eugmes/ais-recv/out/ais-recv-render.jpg

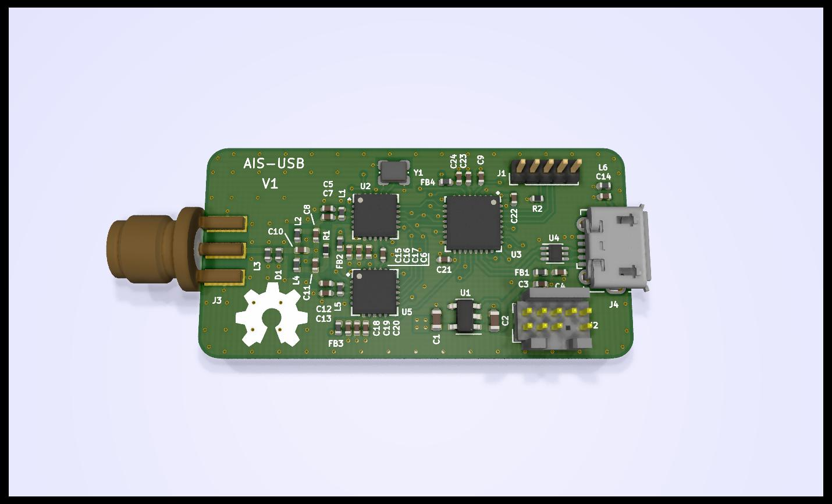
out/ais-recv-render.jpg
