eugmes/ais-recv/out/ais-recv.pdf

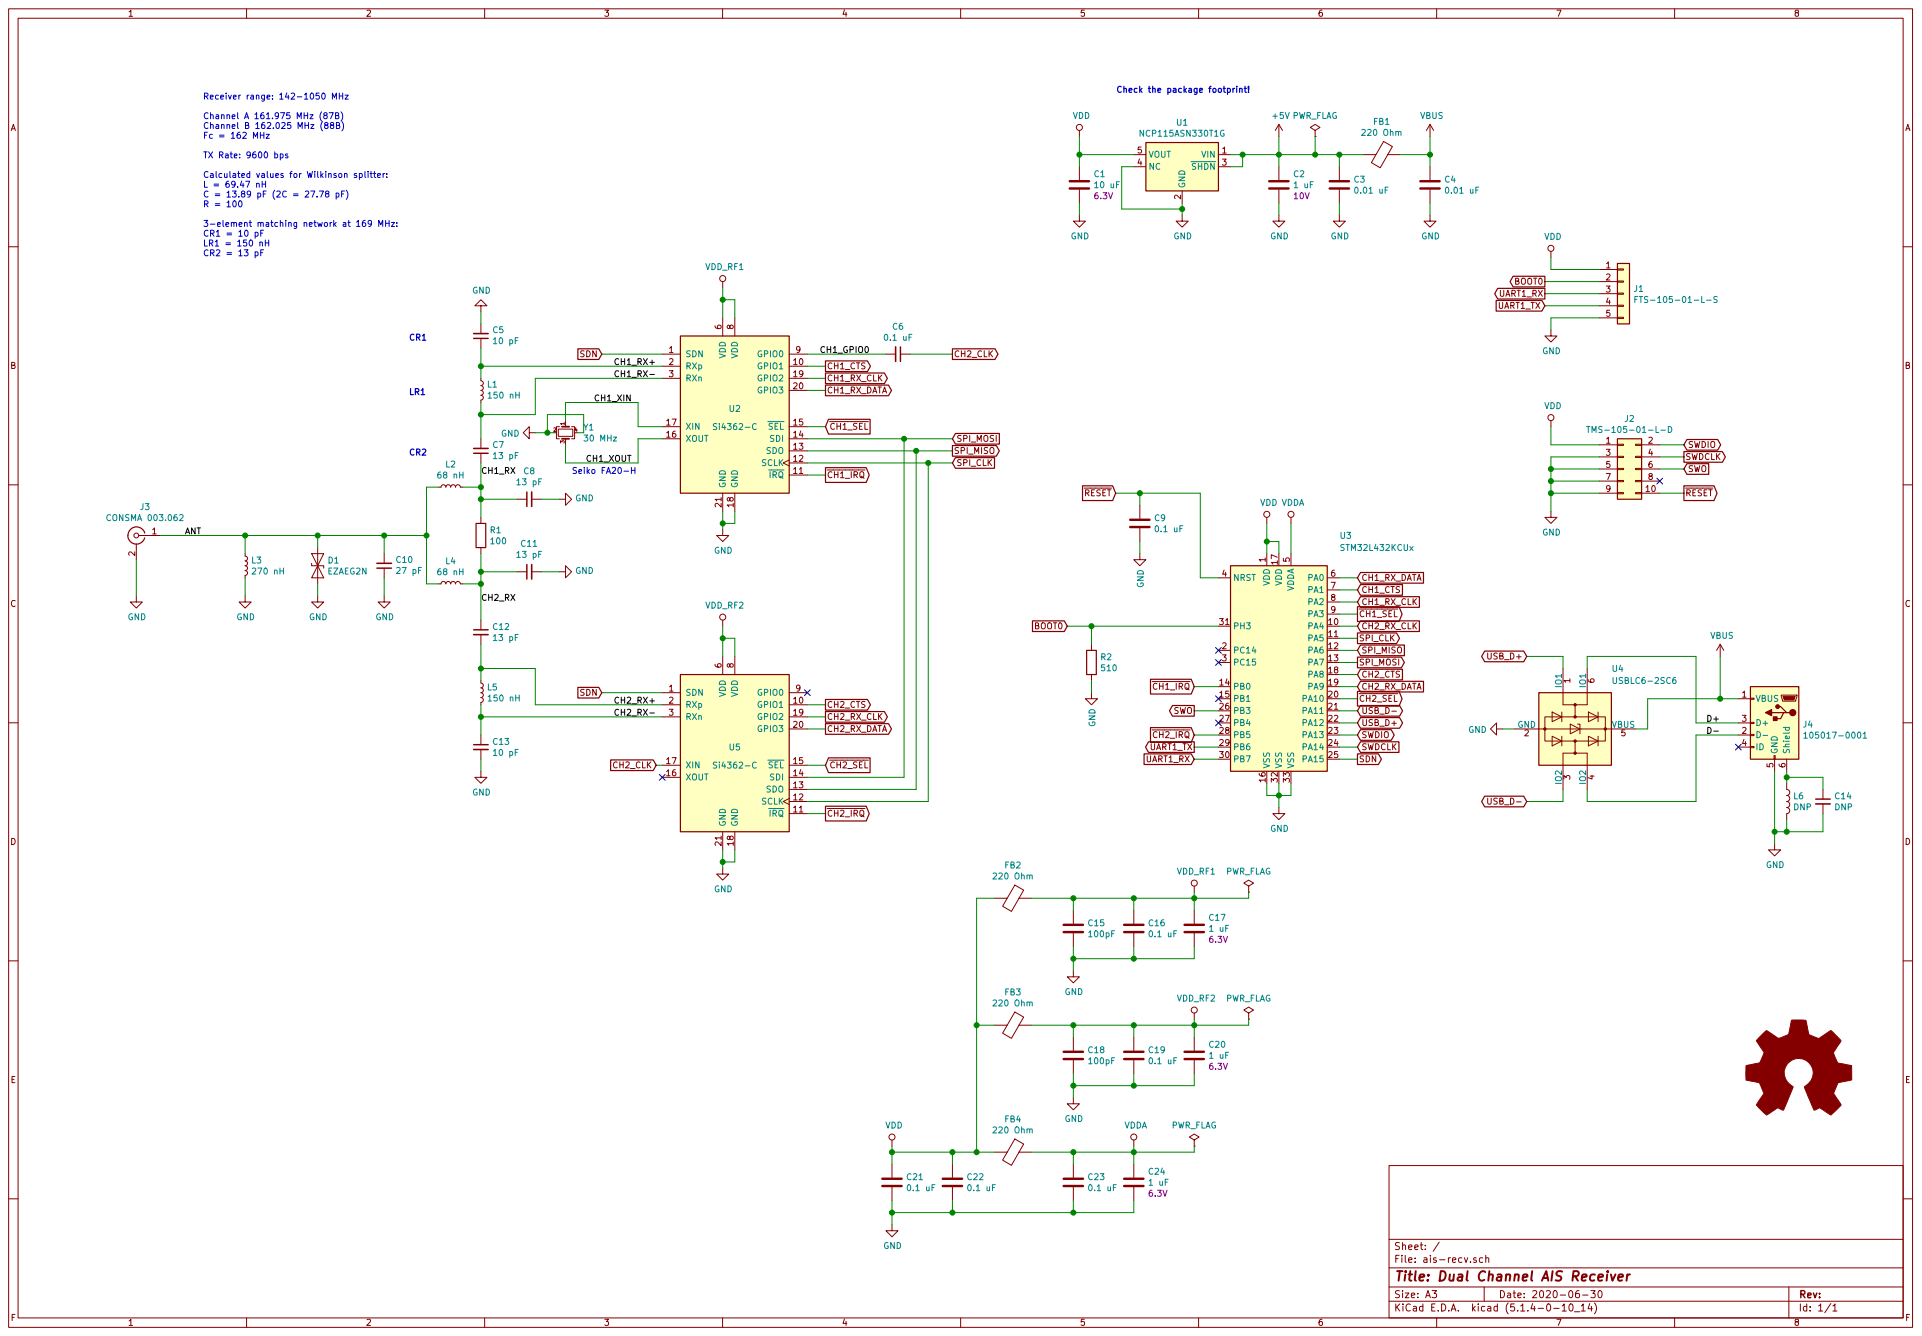
[picture p2: page 1]

Check the package footprint! CR1 Receiver range: 142-1050 MHz

Channel A 161.975 MHz (87B)
Channel B 162.025 MHz (88B) Fc = 162 MHz TX Rate: 9600 bps
10 pF GND

Calculated values for Wilkinson splitter: L = 69.47 nH

3-element matching network at 169 MHz:

Id: 1/1 Title: Dual Channel AIS Receiver File: ais-recv.sch Sheet: /
