eugmes/ais-recv/ais-recv.kicad_pcb

## KiCad design ais-recv.kicad_pcb (2020-08-30)

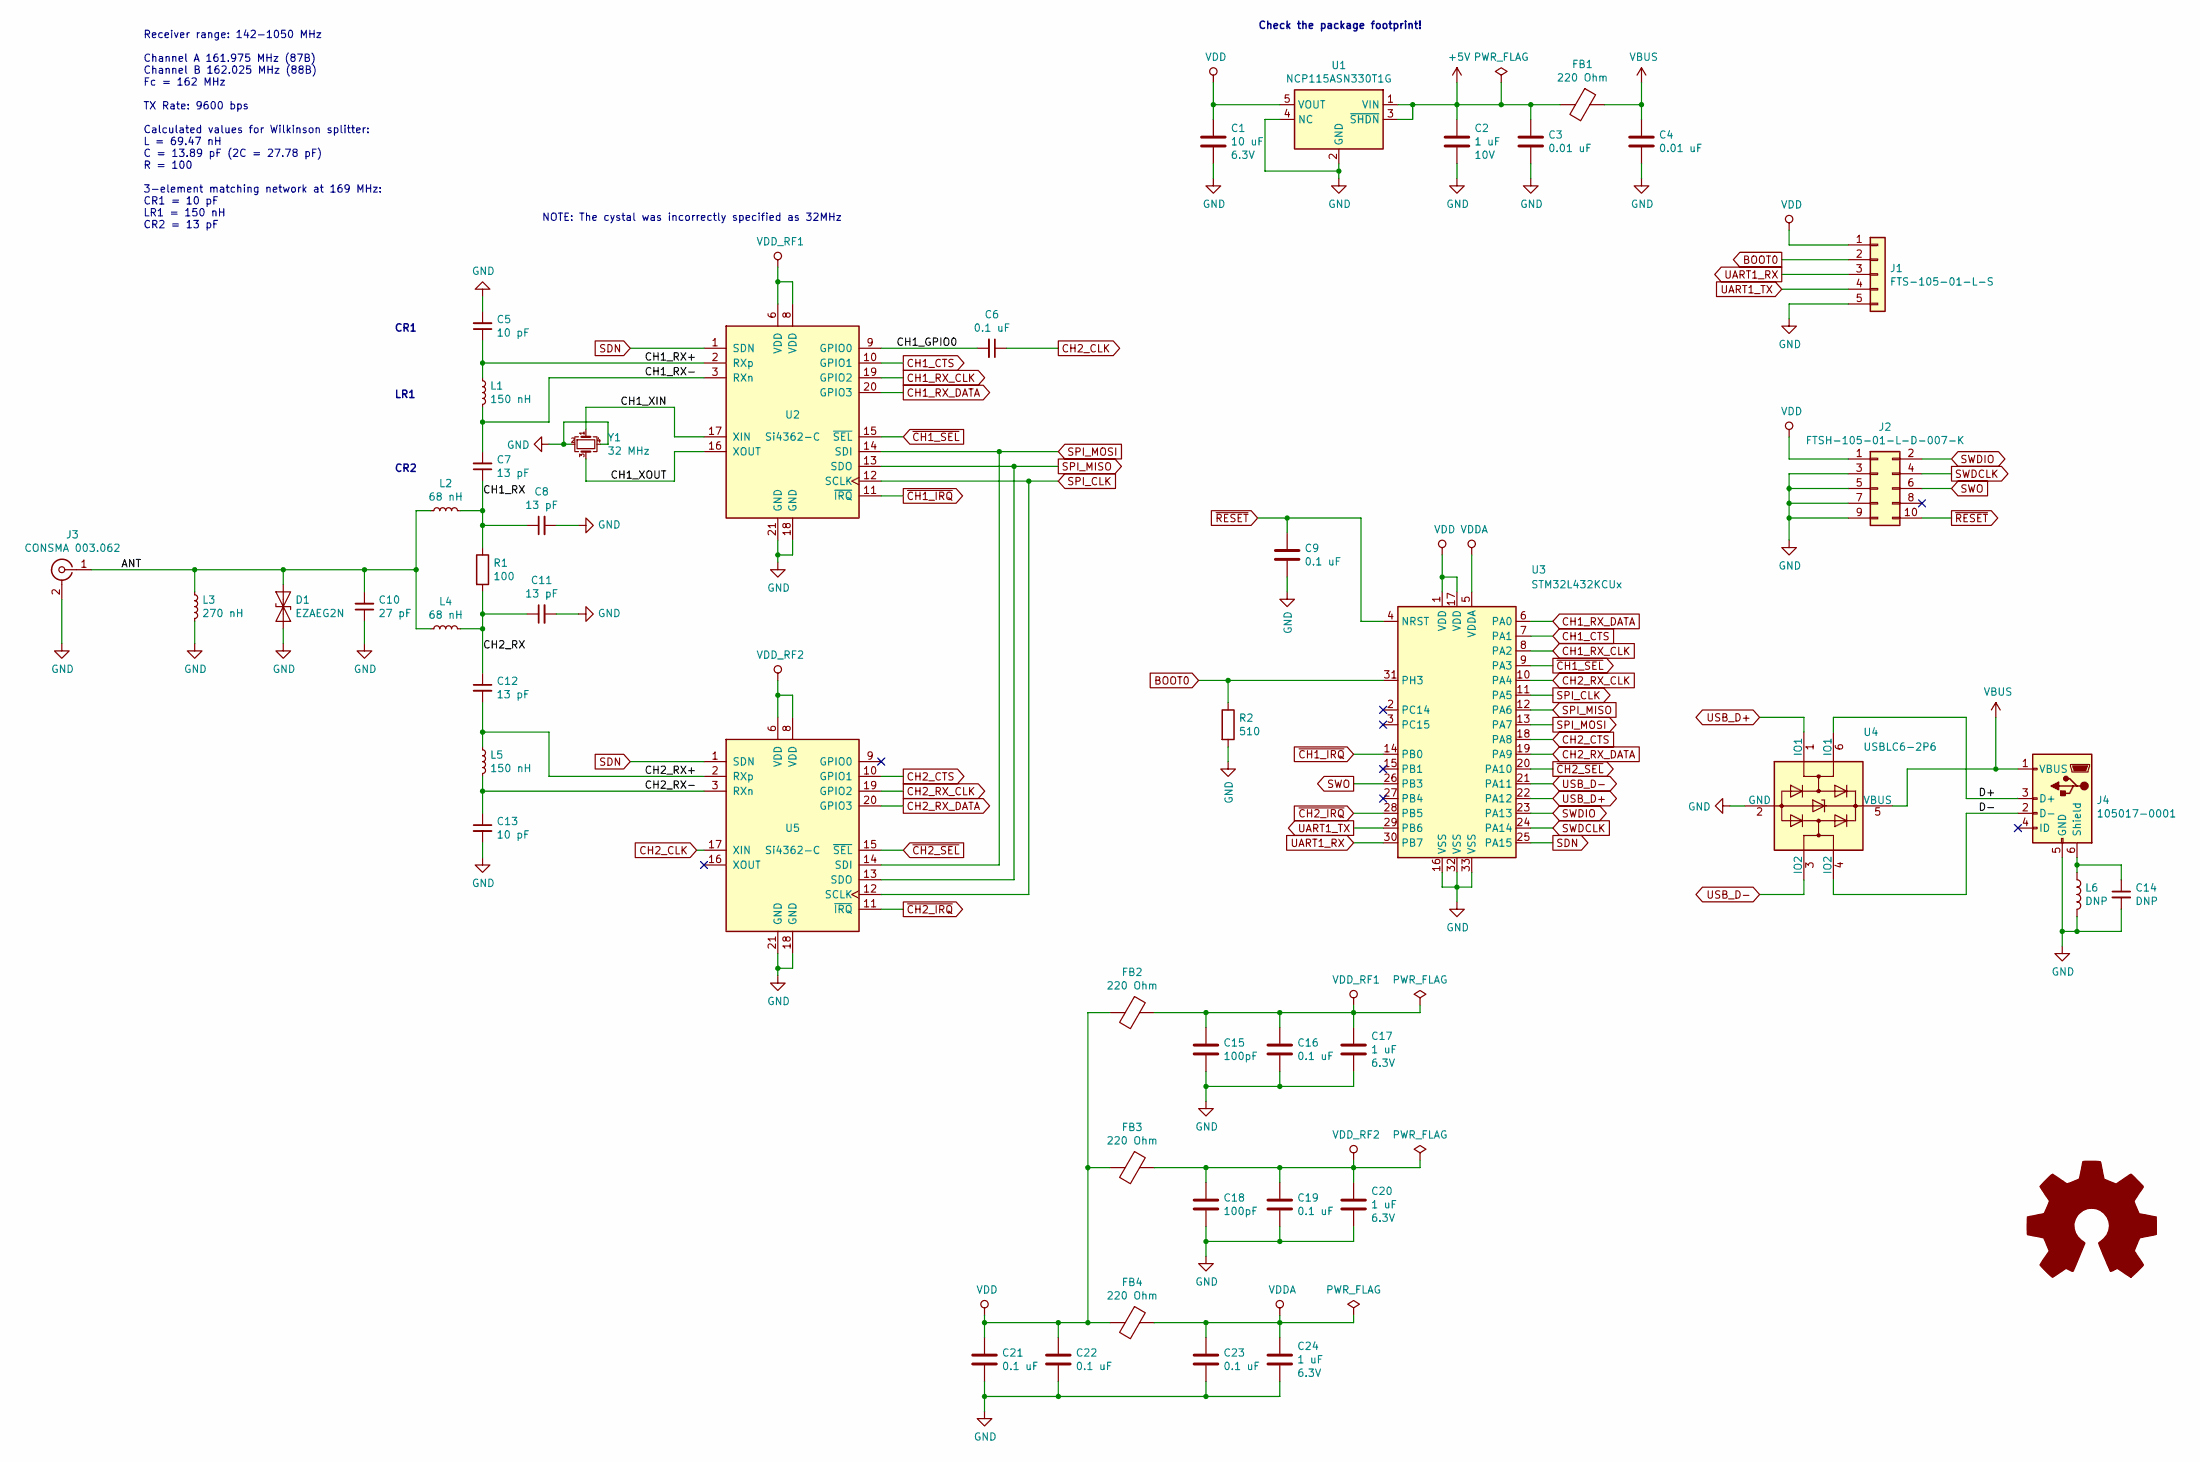
[picture p3: schematic ais-recv.sch, Dual Channel AIS Receiver]

Parts:
C1: 10 uF; CAPC1608X55; Voltage Rating 6.3V
C2: 1 uF; CAPC1608X55; Voltage Rating 10V
C3, C4: 0.01 uF; CAPC1005X55
C5, C13: 10 pF; CAPC1005X55
C6, C9, C16, C19, C21, C22, C23: 0.1 uF; CAPC1005X55
C7, C8, C11, C12: 13 pF; CAPC1005X55
C10: 27 pF; CAPC1005X55
C14: DNP; CAPC1005X55
C15, C18: 100pF; CAPC1005X55
C17, C20, C24: 1 uF; CAPC1005X55; Voltage Rating 6.3V
D1: EZAEG2N; INDC1005X60; MFG Part Num EZAEG2N
FB1, FB2, FB3, FB4: 220 Ohm; INDC1005X60; MFG Part Num MPZ1005S221HT000
J1: FTS-105-01-L-S; PinHeader_1x05_P1.27mm_Vertical; MFG Part Num FTS-105-01-L-S
J2: FTSH-105-01-L-D-007-K; PinHeader_2x05_P1.27mm_Vertical; MFG Part Num FTSH-105-01-L-D-007-K
J3: CONSMA 003.062; SMA_Linx_CONSMA_003_062; MFG Part Num CONSMA 003.062
J4: 105017-0001; USB_Micro-B_Molex-105017-0001; MFG Part Num 105017-0001
L1, L5: 150 nH; INDC1005X60
L2, L4: 68 nH; INDC1005X60
L3: 270 nH; INDC1005X60
L6: DNP; INDC1005X60
LOGO1: Logo_Open_Hardware_Large; OSHW-Symbol_6.7x6mm_SilkScreen
R1: 100; RESC1005X40
R2: 510; RESC1005X40
U1: NCP115ASN330T1G; TSOP-5_1.65x3.05mm_P0.95mm
U2, U5: Si4362-C; QFN50P400X400X80-21B-THERMALVIAS
U3: STM32L432KCUx; QFN50P500X500X80-33-THERMALVIAS
U4: USBLC6-2P6; SOT-666; MFG Part Num USBLC6-2P6
Y1: 32 MHz; OSCCC200X250X080; MFG Part Num ECS-320-12-36B-CTN-TR

Connections:
+5V: C2.1, C3.1, FB1.2, U1.1 (VIN), U1.3 (~SHDN)
/ANT: C10.2, D1.1 (A1), J3.1 (In), L2.1, L3.1, L4.1
/CH1_GPIO0: C6.2, U2.9 (GPIO0)
/CH1_RX: C7.1, C8.1, L2.2, R1.1
/CH1_RX+: C5.1, L1.2, U2.2 (RXp)
/CH1_RX-: C7.2, L1.1, U2.3 (RXn)
/CH1_XIN: U2.17 (XIN), Y1.1
/CH1_XOUT: U2.16 (XOUT), Y1.3
/CH2_RX: C11.1, C12.1, L4.2, R1.2
/CH2_RX+: C12.2, L5.1, U5.2 (RXp)
/CH2_RX-: C13.1, L5.2, U5.3 (RXn)
/D+: J4.3 (D+), U4.6 (IO1)
/D-: J4.2 (D-), U4.4 (IO2)
BOOT0: J1.2, R2.1, U3.31 (PH3)
CH1_CTS: U2.10 (GPIO1), U3.7 (PA1)
CH1_RX_CLK: U2.19 (GPIO2), U3.8 (PA2)
CH1_RX_DATA: U2.20 (GPIO3), U3.6 (PA0)
CH2_CLK: C6.1, U5.17 (XIN)
CH2_CTS: U3.18 (PA8), U5.10 (GPIO1)
CH2_RX_CLK: U3.10 (PA4), U5.19 (GPIO2)
CH2_RX_DATA: U3.19 (PA9), U5.20 (GPIO3)
GND: C1.2, C2.2, C3.2, C4.2, C5.2, C8.2, C9.2, C10.1, C11.2, C13.2, C14.2, C15.2, C16.2, C17.2, C18.2, C19.2, C20.2, C21.2, C22.2, C23.2, C24.2, D1.2 (A2), J1.5, J2.3, J2.5, J2.7, J2.9, J3.2 (Ext), J4.5 (GND), L3.2, L6.2, R2.2, U1.2 (GND), U1.4 (NC), U2.18 (GND), U2.21 (GND), U3.16 (VSS), U3.32 (VSS), U3.33 (VSS), U4.2 (GND), U5.18 (GND), U5.21 (GND), Y1.2, Y1.4
unnamed: C14.1, J4.6 (Shield), L6.1
SDN: U2.1 (SDN), U3.25 (PA15), U5.1 (SDN)
SPI_CLK: U2.12 (SCLK), U3.11 (PA5), U5.12 (SCLK)
SPI_MISO: U2.13 (SDO), U3.12 (PA6), U5.13 (SDO)
SPI_MOSI: U2.14 (SDI), U3.13 (PA7), U5.14 (SDI)
SWDCLK: J2.4, U3.24 (PA14)
SWDIO: J2.2, U3.23 (PA13)
SWO: J2.6, U3.26 (PB3)
UART1_RX: J1.3, U3.30 (PB7)
UART1_TX: J1.4, U3.29 (PB6)
USB_D+: U3.22 (PA12), U4.1 (IO1)
USB_D-: U3.21 (PA11), U4.3 (IO2)
VBUS: C4.1, FB1.1, J4.1 (VBUS), U4.5 (VBUS)
VDD: C1.1, C21.1, C22.1, FB2.2, FB3.2, FB4.2, J1.1, J2.1, U1.5 (VOUT), U3.1 (VDD), U3.17 (VDD)
VDDA: C23.1, C24.1, FB4.1, U3.5 (VDDA)
VDD_RF1: C15.1, C16.1, C17.1, FB2.1, U2.6 (VDD), U2.8 (VDD)
VDD_RF2: C18.1, C19.1, C20.1, FB3.1, U5.6 (VDD), U5.8 (VDD)
~CH1_IRQ: U2.11 (~IRQ), U3.14 (PB0)
~CH1_SEL: U2.15 (~SEL), U3.9 (PA3)
~CH2_IRQ: U3.28 (PB5), U5.11 (~IRQ)
~CH2_SEL: U3.20 (PA10), U5.15 (~SEL)
~RESET: C9.1, J2.10, U3.4 (NRST)

Notes on the sheet:
Receiver range: 142-1050 MHz Channel A 161.975 MHz (87B) Channel B 162.025 MHz (88B) Fc = 162 MHz TX Rate: 9600 bps Calculated values for Wilkinson splitter: L = 69.47 nH C = 13.89 pF (2C = 27.78 pF) R = 100 3-element matching network at 169 MHz: CR1 = 10 pF LR1 = 150 nH CR2 = 13 pF
CR2
LR1
CR1
Check the package footprint!
NOTE: The cystal was incorrectly specified as 32MHz

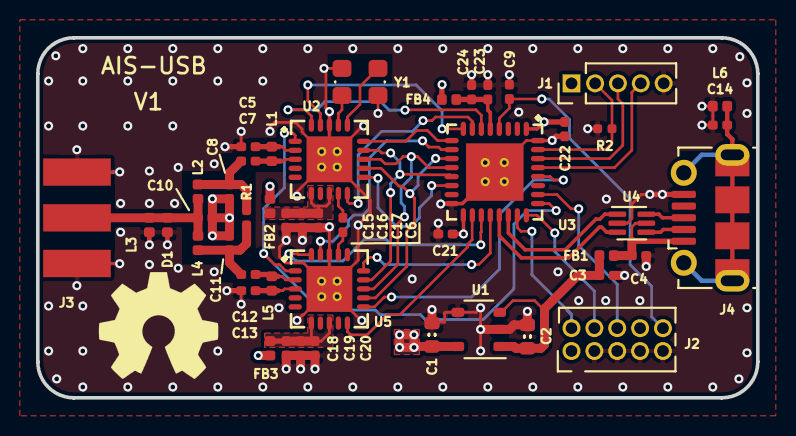
[picture p4: board ais-recv.kicad_pcb from above]

Board: 4 copper layers, 40.0 x 20.0 mm, 48 parts (0 on the bottom side), 44 nets.
