eugmes/ais-recv/(threads)

Thread 1 (2022-05-26):

Buying this product

binu8051, 2022-05-26:
Hi
Me from India and is there anyway to buy this product?
Thanks
Binu

eugmes, 2022-06-06:
Hi, this project is just a hobby project. I'm not selling any products based on it. If you'd like to build your own, you'll have to produce your own PCB and assemble it.

Closed 2022-06-06.
