eugmes/ais-recv/(commit log)

2020-07-23 Initial version using STM32L072KZUx
    The layout is incomplete.
    [ais-recv.kicad_pcb, ais-recv.sch]
2020-07-23 Use STML4
    [ais-recv.kicad_pcb, ais-recv.sch]
2020-07-26 Changes for version 1.0
    [ais-recv.kicad_pcb, ais-recv.sch]
2020-07-26 Add schematic in PDF format
2020-07-26 Add board rendering
2020-08-30 Fix part numbers for the debug connector, USB ESD diodes, quartz
    Add a note about wrong quartz frequency.
    [ais-recv.kicad_pcb, ais-recv.sch]
2020-08-30 Add pads on the bottom of the SMA connector
    [ais-recv.kicad_pcb]
2020-09-22 Remove a note about checking a footprint
    The footprint is correct.
    [ais-recv.sch]
